cccc/u23_2012_hardware/U23_2012.brd

## EAGLE design U23_2012.brd (2012-10-14)

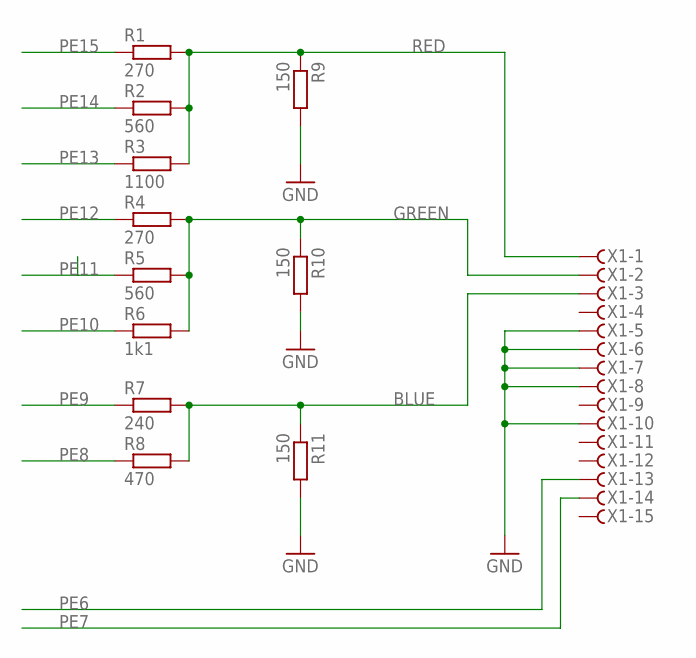
[picture p1: schematic U23_2012.sch, sheet 1, VGA]

Parts:
R1, R4: 270; 0207/10
R2, R5: 560; 0207/10
R3: 1100; 0207/10
R6: 1k1; 0207/10
R7: 240; 0207/10
R8: 470; 0207/10
R9, R10, R11: 150; 0207/10
X1: F15HDHS; HDF15H

Connections:
BLUE: R7.2, R8.2, R11.1, X1.3
GND: R9.2, R10.2, R11.2, X1.5, X1.6, X1.7, X1.8, X1.10; also elsewhere on the board
GREEN: R4.2, R5.2, R6.2, R10.1, X1.2
PE6: X1.13; also elsewhere on the board
PE7: X1.14; also elsewhere on the board
PE8: R8.1; also elsewhere on the board
PE9: R7.1; also elsewhere on the board
PE10: R6.1; also elsewhere on the board
PE11: R5.1; also elsewhere on the board
PE12: R4.1; also elsewhere on the board
PE13: R3.1; also elsewhere on the board
PE14: R2.1; also elsewhere on the board
PE15: R1.1; also elsewhere on the board
RED: R1.2, R2.2, R3.2, R9.1, X1.1

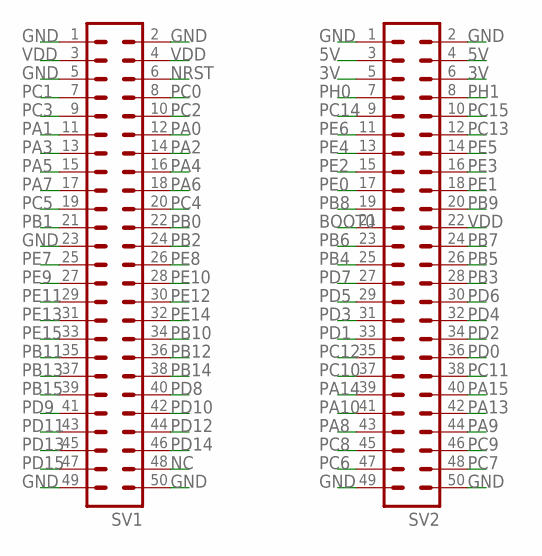
[picture p2: schematic U23_2012.sch, sheet 2, Connector]

Parts:
SV1, SV2: ML50

Connections:
3V: SV2.5, SV2.6; also elsewhere on the board
5V: SV2.3, SV2.4; also elsewhere on the board
BOOT0: SV2.21
GND: SV1.1, SV1.2, SV1.5, SV1.23, SV1.49, SV1.50, SV2.1, SV2.2, SV2.49, SV2.50; also elsewhere on the board
NC: SV1.48
NRST: SV1.6
PA0: SV1.12
PA1: SV1.11; also elsewhere on the board
PA2: SV1.14; also elsewhere on the board
PA3: SV1.13
PA4: SV1.16
PA5: SV1.15
PA6: SV1.18
PA7: SV1.17; also elsewhere on the board
PA8: SV2.43
PA9: SV2.44
PA10: SV2.41
PA13: SV2.42
PA14: SV2.39
PA15: SV2.40
PB0: SV1.22; also elsewhere on the board
PB1: SV1.21; also elsewhere on the board
PB2: SV1.24; also elsewhere on the board
PB3: SV2.28
PB4: SV2.25; also elsewhere on the board
PB5: SV2.26; also elsewhere on the board
PB6: SV2.23
PB7: SV2.24; also elsewhere on the board
PB8: SV2.19; also elsewhere on the board
PB9: SV2.20
PB10: SV1.34
PB11: SV1.35; also elsewhere on the board
PB12: SV1.36; also elsewhere on the board
PB13: SV1.37; also elsewhere on the board
PB14: SV1.38
PB15: SV1.39
PC0: SV1.8
PC1: SV1.7; also elsewhere on the board
PC2: SV1.10
PC3: SV1.9
PC4: SV1.20; also elsewhere on the board
PC5: SV1.19; also elsewhere on the board
PC6: SV2.47
PC7: SV2.48
PC8: SV2.45; also elsewhere on the board
PC9: SV2.46; also elsewhere on the board
PC10: SV2.37; also elsewhere on the board
PC11: SV2.38; also elsewhere on the board
PC12: SV2.35; also elsewhere on the board
PC13: SV2.12
PC14: SV2.9
PC15: SV2.10
PD0: SV2.36; also elsewhere on the board
PD1: SV2.33; also elsewhere on the board
PD2: SV2.34; also elsewhere on the board
PD3: SV2.31; also elsewhere on the board
PD4: SV2.32
PD5: SV2.29; also elsewhere on the board
PD6: SV2.30; also elsewhere on the board
PD7: SV2.27; also elsewhere on the board
PD8: SV1.40; also elsewhere on the board
PD9: SV1.41
PD10: SV1.42
PD11: SV1.43
PD12: SV1.44; also elsewhere on the board
PD13: SV1.45; also elsewhere on the board
PD14: SV1.46; also elsewhere on the board
PD15: SV1.47; also elsewhere on the board
PE0: SV2.17
PE1: SV2.18
PE2: SV2.15
PE3: SV2.16
PE4: SV2.13
PE5: SV2.14
PE6: SV2.11; also elsewhere on the board
PE7: SV1.25; also elsewhere on the board
PE8: SV1.26; also elsewhere on the board
PE9: SV1.27; also elsewhere on the board
PE10: SV1.28; also elsewhere on the board
PE11: SV1.29; also elsewhere on the board
PE12: SV1.30; also elsewhere on the board
PE13: SV1.31; also elsewhere on the board
PE14: SV1.32; also elsewhere on the board
PE15: SV1.33; also elsewhere on the board
PH0: SV2.7
PH1: SV2.8
VDD: SV1.3, SV1.4, SV2.22

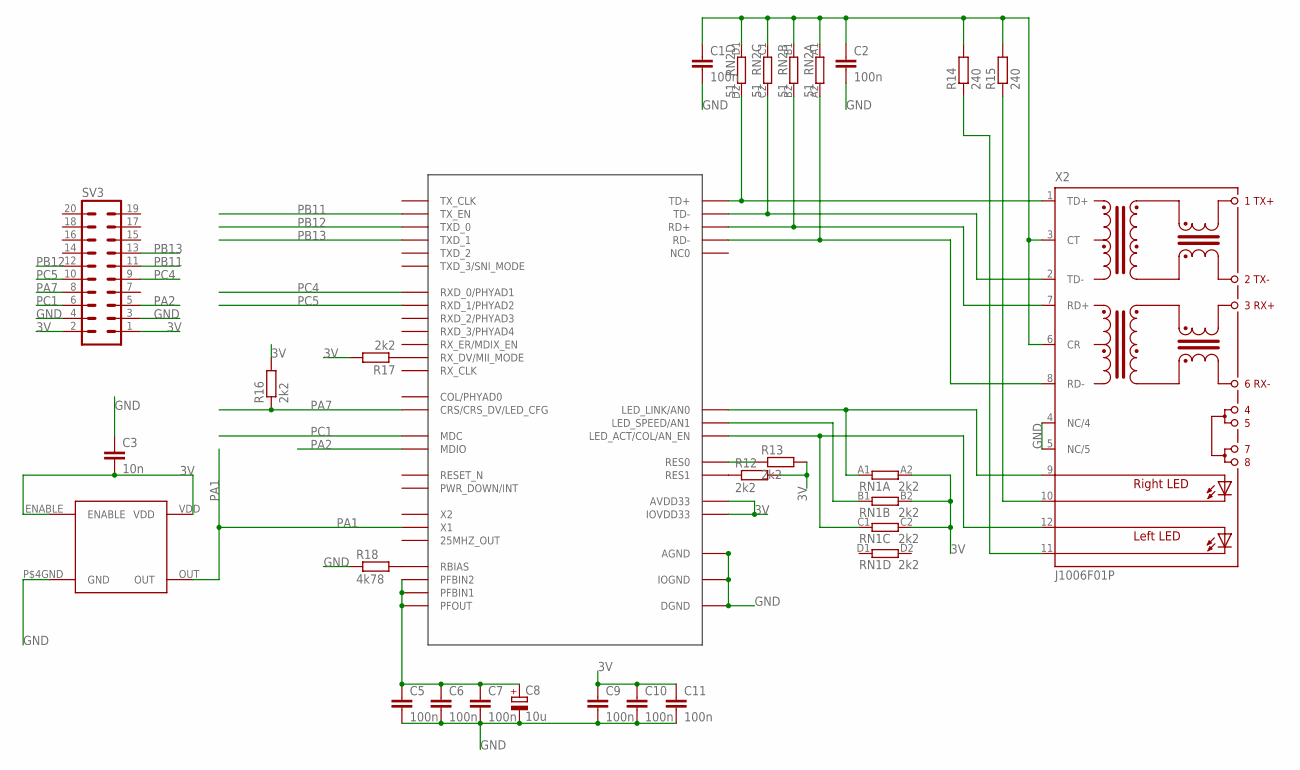
[picture p3: schematic U23_2012.sch, sheet 3, Ethernet]

Parts:
C1, C2, C5, C6, C7, C9, C10, C11: 100n; C0603
C3: 10n; C0603
C8: 10u; SMC_C
R12, R13, R16, R17: 2k2; R0603
R14, R15: 240; R0603
R18: 4k78; R0603
RN1: 2k2; CAR06ES
RN2: 51; CAR06ES
SV3: ML20L
U$1: DP83848CVV; LQFP-44
U$5: 50Mhz; FXO_HC73
X2: J1006F01P; J1

Connections:
3V: C3.2, C9.1, C10.1, C11.1, R12.2, R13.2, R16.2, R17.2, RN1.A2 (2), RN1.B2 (2), RN1.C2 (2), SV3.1, SV3.2, U$1.22 (AVDD33), U$1.32 (IOVDD33), U$1.48 (IOVDD33), U$5.ENABLE, U$5.VDD; also elsewhere on the board
GND: C1.2, C2.2, C3.1, C5.2, C6.2, C7.2, C8.-, C9.2, C10.2, C11.2, R18.1, SV3.3, SV3.4, U$1.15 (AGND), U$1.19 (AGND), U$1.35 (IOGND), U$1.36 (DGND), U$1.47 (IOGND), U$5.P$4GND (GND), X2.4 (NC/4), X2.5 (NC/5); also elsewhere on the board
unnamed: RN2.D2 (2), U$1.17 (TD+), X2.1 (TD+)
unnamed: RN2.C2 (2), U$1.16 (TD-), X2.2 (TD-)
unnamed: RN2.B2 (2), U$1.14 (RD+), X2.7 (RD+)
unnamed: RN2.A2 (2), U$1.13 (RD-), X2.8 (RD-)
unnamed: RN1.A1 (1), U$1.28 (LED_LINK/AN0), X2.9 (A-R)
unnamed: RN1.C1 (1), U$1.26 (LED_ACT/COL/AN_EN), X2.12 (A-L)
unnamed: RN1.B1 (1), U$1.27 (LED_SPEED/AN1)
unnamed: R12.1, U$1.21 (RES1)
unnamed: R13.1, U$1.20 (RES0)
unnamed: C1.1, C2.1, R14.2, R15.2, RN2.A1 (1), RN2.B1 (1), RN2.C1 (1), RN2.D1 (1), X2.3 (CT), X2.6 (CR)
unnamed: R17.1, U$1.39 (RX_DV/MII_MODE)
unnamed: R15.1, X2.10 (C-R)
unnamed: R14.1, X2.11 (C-L)
unnamed: R18.2, U$1.24 (RBIAS)
unnamed: C5.1, C6.1, C7.1, C8.+, U$1.18 (PFBIN1), U$1.23 (PFOUT), U$1.37 (PFBIN2)
PA1: U$1.34 (X1), U$5.OUT; also elsewhere on the board
PA2: SV3.5, U$1.30 (MDIO); also elsewhere on the board
PA7: R16.1, SV3.8, U$1.40 (CRS/CRS_DV/LED_CFG); also elsewhere on the board
PB11: SV3.11, U$1.2 (TX_EN); also elsewhere on the board
PB12: SV3.12, U$1.3 (TXD_0); also elsewhere on the board
PB13: SV3.13, U$1.4 (TXD_1); also elsewhere on the board
PC1: SV3.6, U$1.31 (MDC); also elsewhere on the board
PC4: SV3.9, U$1.43 (RXD_0/PHYAD1); also elsewhere on the board
PC5: SV3.10, U$1.44 (RXD_1/PHYAD2); also elsewhere on the board

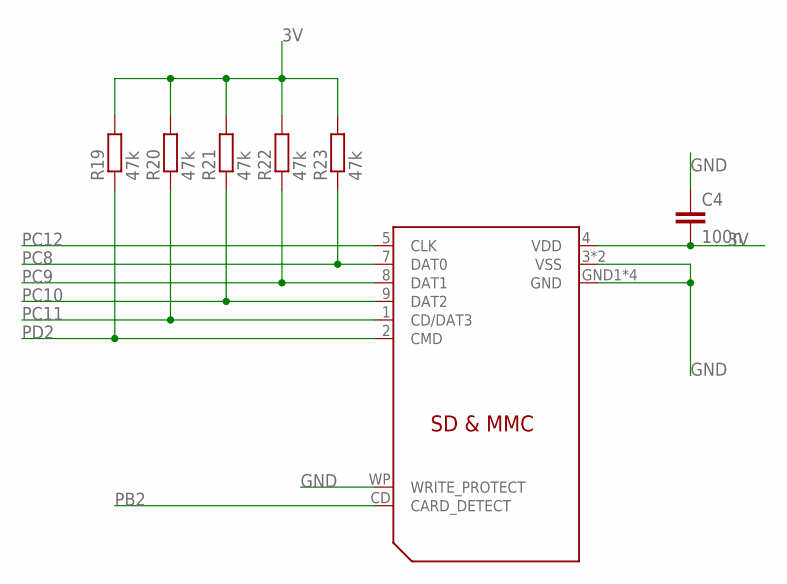
[picture p4: schematic U23_2012.sch, sheet 4]

Parts:
C4: 100n; C025-024X044
R19, R20, R21, R22, R23: 47k; 0207/10
U$2: SD-CARD; SD_CARD

Connections:
3V: C4.2, R19.2, R20.2, R21.2, R22.2, R23.2, U$2.4 (VDD); also elsewhere on the board
GND: C4.1, U$2.3 (VSS), U$2.6 (VSS), U$2.GND1 (GND), U$2.GND2 (GND), U$2.SHIELD1 (GND), U$2.SHIELD2 (GND), U$2.WP (WRITE_PROTECT); also elsewhere on the board
PB2: U$2.CD (CARD_DETECT); also elsewhere on the board
PC8: R23.1, U$2.7 (DAT0); also elsewhere on the board
PC9: R22.1, U$2.8 (DAT1); also elsewhere on the board
PC10: R21.1, U$2.9 (DAT2); also elsewhere on the board
PC11: R20.1, U$2.1 (CD/DAT3); also elsewhere on the board
PC12: U$2.5 (CLK); also elsewhere on the board
PD2: R19.1, U$2.2 (CMD); also elsewhere on the board

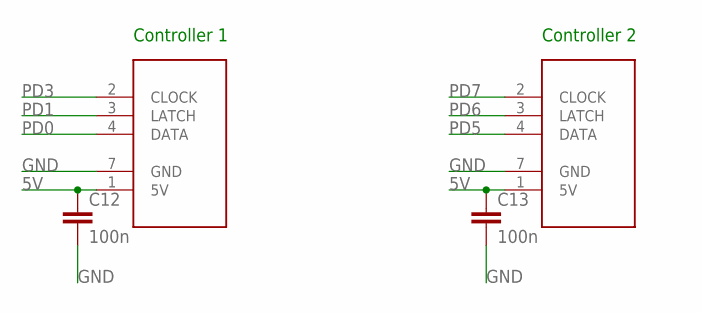
[picture p5: schematic U23_2012.sch, sheet 5]

Parts:
C12, C13: 100n; C025-024X044
U$3, U$4: SNES

Connections:
5V: C12.1, C13.1, U$3.1 (5V), U$4.1 (5V); also elsewhere on the board
GND: C12.2, C13.2, U$3.7 (GND), U$4.7 (GND); also elsewhere on the board
PD0: U$3.4 (DATA); also elsewhere on the board
PD1: U$3.3 (LATCH); also elsewhere on the board
PD3: U$3.2 (CLOCK); also elsewhere on the board
PD5: U$4.4 (DATA); also elsewhere on the board
PD6: U$4.3 (LATCH); also elsewhere on the board
PD7: U$4.2 (CLOCK); also elsewhere on the board

Notes on the sheet:
Controller 1
Controller 2

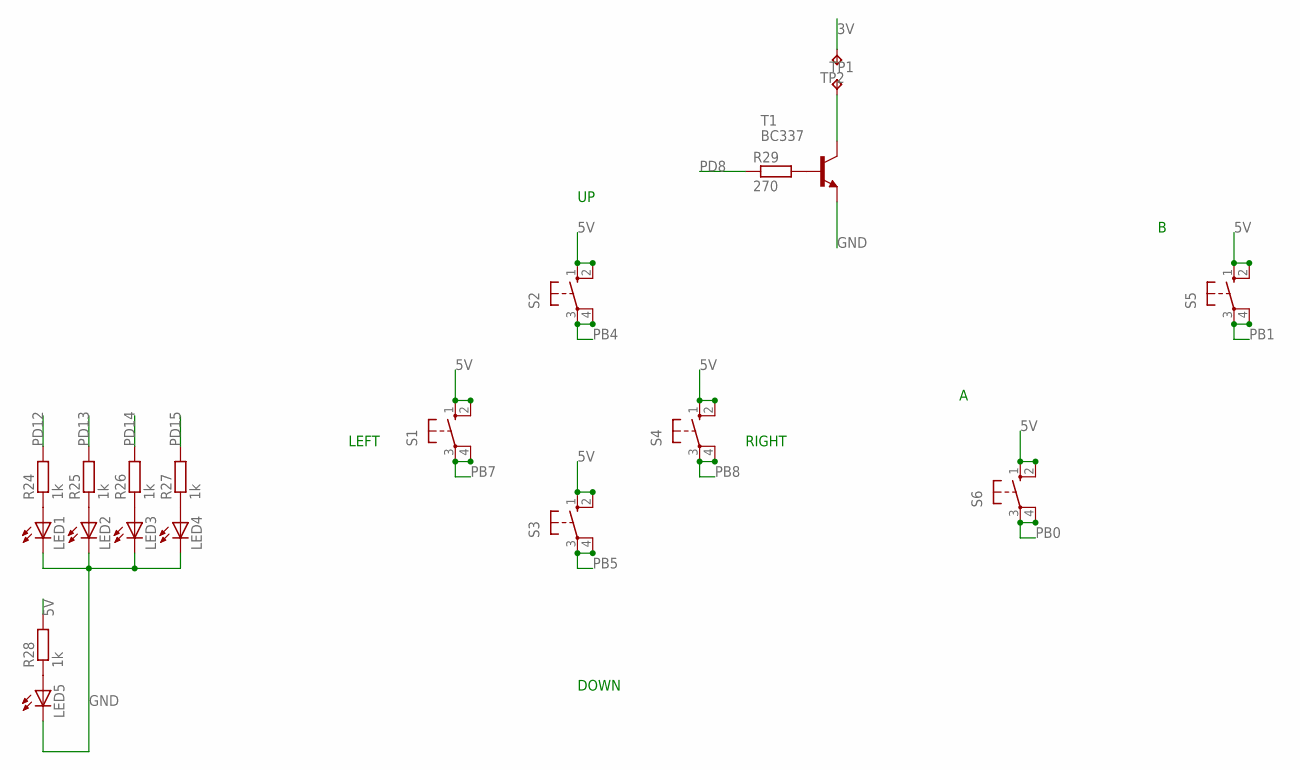
[picture p6: schematic U23_2012.sch, sheet 6]

Parts:
LED1, LED2, LED3, LED4, LED5: LED3MM
R24, R25, R26, R27, R28: 1k; 0207/10
R29: 270; 0207/10
S1, S2, S3, S4, S5, S6: 10-XX; B3F-10XX
T1: BC337; TO92
TP1, TP2: TPTP20SQ; TP20SQ

Connections:
3V: TP2.TP; also elsewhere on the board
5V: R28.2, S1.1 (S), S1.2 (S1), S2.1 (S), S2.2 (S1), S3.1 (S), S3.2 (S1), S4.1 (S), S4.2 (S1), S5.1 (S), S5.2 (S1), S6.1 (S), S6.2 (S1); also elsewhere on the board
GND: LED1.K (C), LED2.K (C), LED3.K (C), LED4.K (C), LED5.K (C), T1.1 (E); also elsewhere on the board
unnamed: LED1.A, R24.1
unnamed: LED2.A, R25.1
unnamed: LED3.A, R26.1
unnamed: LED4.A, R27.1
unnamed: LED5.A, R28.1
unnamed: R29.2, T1.2 (B)
unnamed: T1.3 (C), TP1.TP
PB0: S6.3, S6.4 (P1); also elsewhere on the board
PB1: S5.3, S5.4 (P1); also elsewhere on the board
PB4: S2.3, S2.4 (P1); also elsewhere on the board
PB5: S3.3, S3.4 (P1); also elsewhere on the board
PB7: S1.3, S1.4 (P1); also elsewhere on the board
PB8: S4.3, S4.4 (P1); also elsewhere on the board
PD8: R29.1; also elsewhere on the board
PD12: R24.2; also elsewhere on the board
PD13: R25.2; also elsewhere on the board
PD14: R26.2; also elsewhere on the board
PD15: R27.2; also elsewhere on the board

Notes on the sheet:
DOWN
RIGHT
LEFT

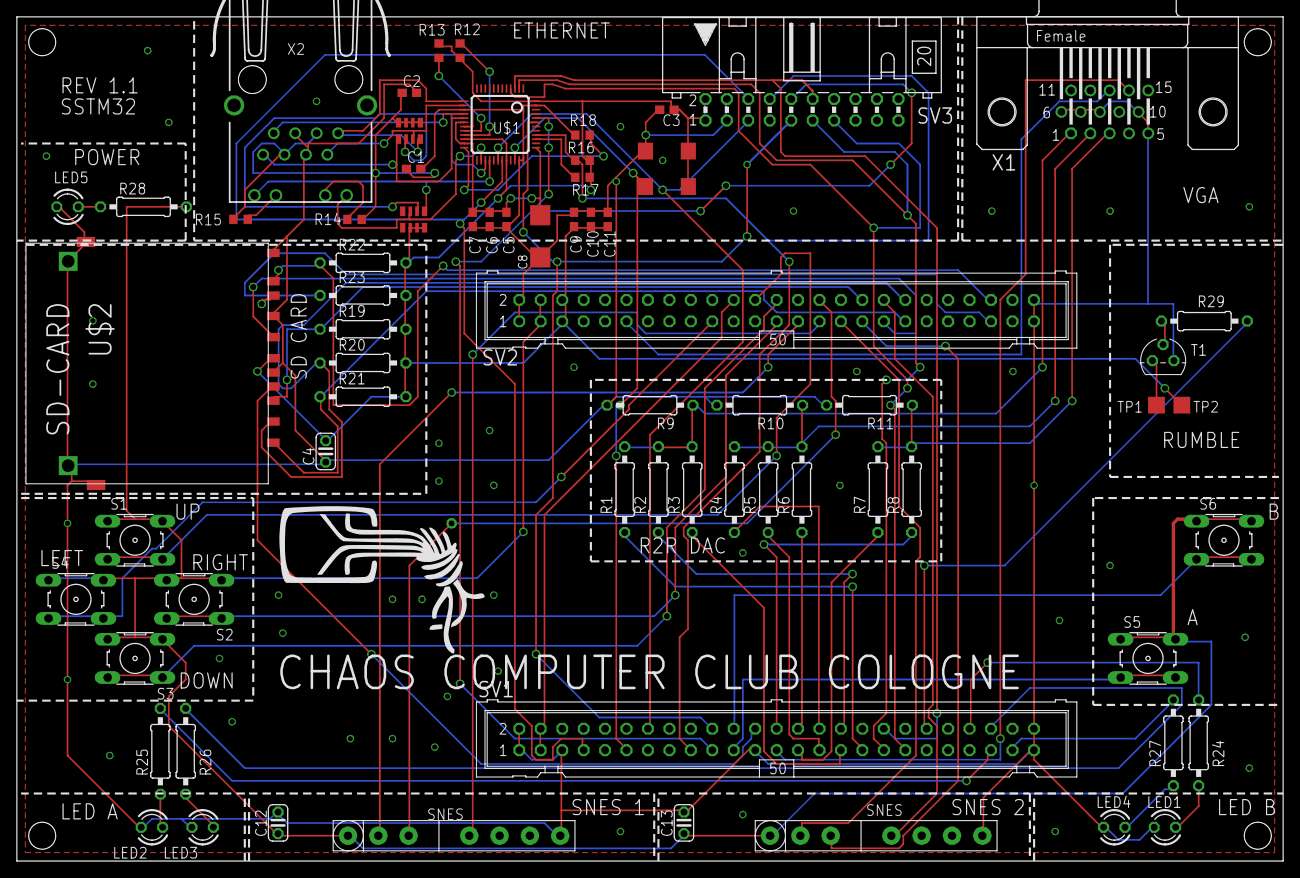
[picture p7: board U23_2012.brd from above]

Board: 2 copper layers, 150.0 x 100.0 mm, 68 parts (0 on the bottom side), 72 nets.
