cccc/u23_2012_hardware/(commit log)

2012-09-30 adds misc page
    [U23_2012.brd, U23_2012.sch]
2012-09-30 adds bom/partlist/pins
    [BOM.csv, pins.xls]
2012-09-30 removes pulldowns of buttons, due to internal pulldowns of MCU. Reexports netlist etc.
    [BOM.csv, U23_2012.brd, U23_2012.sch, pins.xls]
2012-09-30 adds missing base resistor to T1
    [BOM.csv, U23_2012.brd, U23_2012.sch, pins.xls]
2012-09-30 adds cheaper sources
    [BOM.csv]
2012-10-03 board rev 0.1
    [U23_2012.brd, U23_2012.sch]
2012-10-03 fixes wrong routed signal
    [U23_2012.brd]
2012-10-03 adds drill files
2012-10-12 adds connector to http://www.wvshare.com/product/DP83848-Ethernet-Board.htm Ethernet boards switches position of LED1 and LED5 adds silkscreen annotations etc removes pdf and drill files
    [U23_2012.brd, U23_2012.sch]
2012-10-13 removes stupid mistake on ethernet jack
    [U23_2012.brd, U23_2012.sch]
2012-10-13 fixes not connected vias. rev_1.1
    [U23_2012.brd]
2012-10-14 fixes wrong named ground plane
    committed to seed studio, rev_1.1_u23_final
    adds committed zip file
    [U23_2012.brd]
